lumosaily9/UWOC-FPGA/report/ai_collaboration.md

# 人机协作研发记录

项目名称：水下无线光通信智能收发终端

本记录按研发任务回溯整理，任务提示归纳工程问题，模型答复记录技术结论，人工反馈与验证结果共同构成问题闭环。协作贯穿系统架构、FPGA逻辑、软硬件接口、信号处理和测试验证。

## 一 协作组织与技术路线

团队负责应用需求、器件接口、硬件连接和工程取舍。大模型参与模块分解、时序分析、算法定点化、测试激励与异常定位。每项任务以明确的输入、输出和检查条件展开，通过源码分析及测试结果决定修改方向。

系统按PL实时处理、PS帧级调度、计算机数据接收划分。PL承担信道编解码、同步识别、串并转换和帧整理，PS承担FIFO水位读取、DMA控制、DDR缓存及UDP交付。幅度域扩展围绕选相、定点FFE和码元缓存单独组织。

## 二 系统架构与帧结构设计

**任务提示**

以Zynq-7010为处理平台，实现20 Mbps OOK水下光通信。请结合蓝光LD发射、单路PMT接收和以太网数据交付，划分PL与PS任务，明确帧结构及模块接口。

**模型答复与分析**

将固定节拍的串行收发、同步检测、RS编解码和字节交付放入PL，将整帧搬运与网络转发放入PS。发送端以239字节信息为输入，经RS(255,239)编码形成255字节码字，在码字前组织44 bit同步序列。接收端识别同步边界，恢复码字并译码，提取239字节信息后送入DMA。

**人工反馈与设计取舍**

团队确定20 Mbps OOK及现有光电接口，按发送、接收和质量观察三条通路组织功能。同步、帧末和有效握手作为模块之间的交接条件，PS以信息帧为单位调度数据。

**形成结果**

明确239字节信息、255字节码字和239字节网络载荷之间的关系，使编码、恢复和数据交付使用一致的帧边界。

## 三 串行时序分析与末位保持

**任务提示**

在200 MHz逻辑时钟下输出20 Mbps串行码流，检查位周期、字节边界、同步段与码字末位，分析最后一个字节恢复异常的原因。

**模型答复与分析**

200 MHz时钟周期为5 ns，每位保持10个时钟周期，对应50 ns位周期。由移位寄存器和位计数确定实际串行格式，数据字节按低位优先连续发送。码字末位输出后需要完整保持一个位周期，再退出发送状态。

**自我纠错轨迹**

最初从模块名称推断标准UART格式。追踪8位移位寄存器、位计数和同步状态后，将分析修正为连续8位字节与44 bit同步段。末字节设为0x80时，仿真暴露出最高位提前结束的问题，随后增加末位保持状态。非末字节切换仍按非阻塞赋值的旧值语义输出当前字节末位，同时装载下一字节。

**验证结果**

串行仿真恢复末字节0x80，末位完整保持10个周期。发送与接收自环核对255字节码字的首尾、顺序和帧末标志。

## 四 流接口反压与帧边界处理

**任务提示**

AXI流在连续就绪时能够传输，后级短时暂停后出现字节跳失。请检查数据消费条件、输出保持和TLAST位置，给出接收缓存的处理方式。

**模型答复与分析**

输入计数仅在TVALID与TREADY同时有效时推进。输出有效而后级未就绪时，保持TDATA、TLAST及有效标志。串行输入继续到达时，将已经恢复的等待字节与对应帧末标志共同保留，后级恢复后再交付。

**人工反馈与迭代**

将连续流激励扩展为间断就绪激励，分别检查码字组帧、信息提取和串行接收。根据失败字节位置核对计数推进，调整等待缓存的交付条件。

**验证结果**

反压场景下，两帧码字共510字节完整交付，信息提取输出两帧共478字节，数据与TLAST均与参考一致。接收缓存的配置同时结合串行字节间隔及后级停顿长度确定。

## 五 误码统计与计数位宽核对

**任务提示**

设计RS译码后载荷的误码统计，检查单字节全部错误、整帧全部错误及多帧累计，确定计数器位宽与串口输出格式。

**模型答复与分析**

接收载荷与参考序列逐位比较，每帧统计239字节，即1912 bit。单字节错误数范围为0至8，计数器需要4位。累计1000帧对应1 912 000 bit，串口输出四字节FF帧头和三字节错误计数。

**自我纠错轨迹**

单字节8位全错激励得到0，定位到3位中间计数器回绕。将位宽扩为4位后，分别注入0、1、8和1912个错误比特，核对中间计数及整帧累计结果。

**验证结果**

四组错误注入计数全部一致，误码统计使用RS译码后的有效载荷作为比较对象。

## 六 DMA调度与网络交付

**任务提示**

接收侧需要连续完成FIFO到DDR的数据搬运，并通过UDP交付信息帧。请检查DMA启动、完成、错误恢复和缓存一致性，分析忙状态无法释放及发送长度不一致的问题。

**模型答复与分析**

连续接收时，FIFO占用达到300字节后提交容量300字节的S2MM接收，当前信息帧在第239字节通过TLAST结束。DMA启动成功后置忙，完成中断使接收缓存失效并设置完成标志，主循环发送239字节UDP载荷后释放忙状态。错误中断设置错误标志，复位与调度恢复由主循环处理。

**人工反馈与迭代**

围绕启动失败、完成中断及异常恢复分别组织检查，避免一次失败阻断后续任务。网络发送函数按传入长度处理数据，信息帧调用保持239字节。

**验证结果**

UDP、DMA和主循环三组主机C函数测试通过。本地UDP回环接收3个数据报，共717字节，保存内容逐字节一致。

## 七 幅度域FFE与缓存优化

**任务提示**

为20 MBd OOK构建幅度域处理扩展，采样率120 MSa/s。请设计码元选相、五抽头FFE及定点数据格式，并分析业务缓存保存全部样点与仅保存码元幅度的资源差异。

**模型答复与分析**

每码元包含6个样点，选相后将12位码元幅度写入保护FIFO，读出后减去2048转为有符号样值，再进入码元间隔五抽头FFE。系数为16位有符号Q13数，乘积采用28位，累加采用31位，右移13位后饱和为12位输出，再进行门限判决。

**人工反馈与设计取舍**

按有效信号管理样值推进，后级暂停时保持流水数据。将码元选样放在业务FIFO之前，使缓存深度按码元数配置，保留定点乘加、饱和和帧内参数稳定的接口约束。

**验证结果**

扩展RTL完成6组回归。4组系数下4096个样值与整数参考一致，覆盖正负饱和和反压保持。相同1024码元配置下，FIFO逻辑数据容量由73 728 bit降为12 288 bit，减少83.33%。

## 八 协作工作流与问题闭环

研发任务按PL逻辑、PS控制、测试验证和系统集成分解。模型分析源码与约束，提出实现或激励方案，团队确定接口和取舍，再以测试结果反馈修订。

工作流为：需求与接口输入 → 模块拆解 → 模型分析 → 人工取舍 → 实现与测试 → 失败定位 → 修订回归 → 系统集成。
