lumosaily9/UWOC-FPGA/sim/results/baseline/README.md

# 优化前对比回归

本目录保存原始RTL在20 Mbps、200 MHz测试配置下的运行日志。相同激励由当前sim目录的测试提供，10项用例中3项通过。优化后的结果位于上一级目录，10项全部通过。

原始工程提交为13d41ebe76c9aa6b042e6da6cba2ef24ab2048f2。该目录用于对应设计报告第4章的优化前后对比。
