lumosaily9/UWOC-FPGA/src/ip_repo/uart2fifo_v2/uart2fifo_50m.v

module uart2fifo_v2 #(
   parameter CLK_FREQ = 200_000_000,   // 系统时钟频率 (200 MHz)
    parameter BAUD_RATE = 20_000_000    // 串行码元速率 (20 MBd)
)(
    // Global Signals
    input               clk,        // 系统时钟
    input               resetn,
    
    // RS Signals 
    input               data_in,    // 串行数据输入
    
    // AXI-Stream Master Interface
    output reg          m_axis_tvalid,
    output reg  [7:0]   m_axis_tdata,
    output reg          m_axis_tlast,  // 数据包结束标志
    input               m_axis_tready,
     output wire  [0:0]      Waiting_first_high,
      output wire  [0:0]      First_high_valid,
      output wire   [0:0]      Half_sample_done, 
    output wire   [2:0]    state
    
); 

// 接收状态机
reg     [15:0]  clk_cnt;        // 波特率计数器
reg     [7:0]   data_buf;       // 数据缓存
reg     [3:0]   data_cnt;       // 数据位计数器
reg     [2:0]   STATE;          // 主状态机
reg     [7:0]   pkt_counter;    // 数据包字节计数器 (0-254)

// 接收等待缓存寄存器
reg     [7:0]   pending_data;   // 等待发送的数据缓存
reg             has_pending;    // 缓存有效标志

reg pending_last;

// ============= 同步序列检测寄存器 =============
reg     [31:0]  sync_shift_reg; // 同步序列移位寄存器
reg     [7:0]   sync_cnt;       // 同步序列位计数器
reg             sync_detected;  // 同步序列检测标志
reg     [7:0]   zero_cnt;       // 连续0计数器
reg      [0:0]       waiting_first_high; // 等待第一个高电平标志
reg       [0:0]      first_high_valid;
reg       [0:0]     half_sample_done;   // 半周期采样完成标志
reg [0:0] flag;
reg [2:0] safe;
// =================================================

// 动态计算波特率分频系数
localparam BAUD_DIV = (CLK_FREQ / BAUD_RATE) - 1;  // 波特率分频系数
localparam HALF_BAUD_DIV = (BAUD_DIV + 1) / 2 - 1; // 半波特率周期值

// 接收状态定义
localparam [2:0] 
    SYNC_DETECT = 3'b000,   // 同步序列检测状态
    IDLE        = 3'b001,
    START       = 3'b010,
    STOP        = 3'b011;

// 同步序列常量 (00010101010101010101 低位先发)
localparam [31:0] SYNC_PATTERN = 32'b01010101010101010101010101010101;
assign state=STATE;
assign  Waiting_first_high= waiting_first_high;
assign  First_high_valid= first_high_valid;
assign  Half_sample_done = half_sample_done; 


wire byte_complete = (STATE == START) && (clk_cnt == BAUD_DIV) && (data_cnt == 8);

// 主状态机
always @(posedge clk or negedge resetn) begin
    if (!resetn) begin
        STATE           <= SYNC_DETECT;  // 复位后进入同步检测状态
        clk_cnt         <= 16'h0;
        data_cnt        <= 4'h0;
        data_buf        <= 8'h00;
        m_axis_tvalid   <= 1'b0;
        m_axis_tdata    <= 8'h0;
        m_axis_tlast    <= 1'b0;
        pkt_counter     <= 8'd0;
        pending_data    <= 8'h0;
        has_pending     <= 1'b0;
        pending_last    <= 1'b0;

        
        // ============= 同步检测复位 =============
        sync_shift_reg  <= 32'h0;
        sync_cnt        <= 6'h0;
        sync_detected   <= 1'b0;
        zero_cnt        <= 8'h0;
        waiting_first_high <= 1'b0;
        half_sample_done   <= 1'b0;
        first_high_valid    <= 1'b0;
          flag<=1'b0;
        // =========================================
    end 
    else begin
        // Two-entry elastic output: data/last remain stable until accepted.
        if (m_axis_tvalid && m_axis_tready) begin
            if (has_pending) begin
                m_axis_tdata <= pending_data;
                m_axis_tlast <= pending_last;
                m_axis_tvalid <= 1'b1;
                has_pending <= 1'b0;
            end else begin
                m_axis_tvalid <= 1'b0;
                m_axis_tlast <= 1'b0;
            end
        end
        if (byte_complete) begin
            if (!m_axis_tvalid || (m_axis_tready && !has_pending)) begin
                m_axis_tdata <= data_buf;
                m_axis_tlast <= (pkt_counter == 8'd254);
                m_axis_tvalid <= 1'b1;
            end else if (!has_pending || m_axis_tready) begin
                pending_data <= data_buf;
                pending_last <= (pkt_counter == 8'd254);
                has_pending <= 1'b1;
            end
        end
        case (STATE)
            // ============= 同步序列检测 =============
             SYNC_DETECT: begin

          
                
                // 波特率计数
                if (!waiting_first_high) begin
                 if (clk_cnt == BAUD_DIV)begin
                    clk_cnt <= 0;
                    
                    // 阶段1: 检测连续8位0
                    if (!waiting_first_high && !half_sample_done) begin
                        if (data_in == 1'b0) begin
                            if (zero_cnt == 8'd6) begin
                                // 检测到连续8位0，进入等待高电平阶段
                                waiting_first_high <= 1'b1;
                                zero_cnt <= 8'h0;
                                 STATE <= SYNC_DETECT;
                            end else begin
                                zero_cnt <= zero_cnt + 1;
                                 STATE <= SYNC_DETECT;
                            end
                        end else begin
                            zero_cnt <= 8'h0; // 遇到1，清零计数器
                            STATE <= SYNC_DETECT;
                        end
                    end 
                    end else begin
                    clk_cnt <= clk_cnt + 1;
                    STATE <= SYNC_DETECT;
                    end
                end
                    // 阶段2: 等待第一个高电平并验证
                   if (waiting_first_high && !half_sample_done) begin
                        if (data_in == 1'b1) begin
                            // 检测到高电平，启动半周期验证
                            zero_cnt <= 8'h0;
                            half_sample_done <= 1'b1;
                            clk_cnt <= 0; // 重置计数器用于半周期采样
                            STATE <= SYNC_DETECT;
                        end 
                    end
                    // 阶段3: 半周期后验证高电平
                    if (half_sample_done && !first_high_valid) begin
                     if (clk_cnt == HALF_BAUD_DIV)begin
                        if (data_in == 1'b1) begin
                            // 高电平验证成功，开始检测32位交替同步模式
                         
                             first_high_valid<= 1'b1;
                             sync_shift_reg <= {data_in, sync_shift_reg[31:1]};
                            sync_cnt <= sync_cnt + 1;  
                            clk_cnt <= 0;
                            STATE <= SYNC_DETECT;
                        end else begin
                            // 验证失败，重新开始
                            half_sample_done <= 1'b0;
                            zero_cnt <= 8'h0;
                            waiting_first_high <= 1'b0;
                            STATE <= SYNC_DETECT;
                        end
                        end else begin
                        clk_cnt <= clk_cnt + 1;
                        STATE <= SYNC_DETECT;
                        end
                    end
                    // 阶段4: 检测32位交替同步模式
                    if ( first_high_valid) begin
                        if (clk_cnt == BAUD_DIV) begin
                            clk_cnt <= 0;
                            sync_shift_reg <= {data_in, sync_shift_reg[31:1]};
                            sync_cnt <= sync_cnt + 1;
                         
                            // 完成交替模式采样后进行比较
                            if (sync_cnt == 8'd32) begin
                                if (sync_shift_reg == SYNC_PATTERN) begin
                                    first_high_valid   <=1'b0;
                                    sync_shift_reg  <=32'd0;
                                     zero_cnt <= 8'h0;
                                      half_sample_done    <=1'b0;
                                    sync_cnt <= 6'h0;
                                     waiting_first_high <= 1'b0;
                                    STATE <= IDLE;
                                end else begin
                                    // 同步序列不匹配，重新开始检测
                                    first_high_valid   <=1'b0;
                                    zero_cnt <= 8'h0;
                                    sync_cnt <= 6'h0;
                                      half_sample_done    <=1'b0;
                                    sync_shift_reg<=32'd0;
                                    waiting_first_high <= 1'b0;
                                    STATE <= SYNC_DETECT;
                                end
                            end
                        end else begin
                            clk_cnt <= clk_cnt + 1;
                            STATE <= SYNC_DETECT;
                        end
                    end
                end 
            
            // =============================================
            
            // IDLE状态：优先处理缓存数据
            IDLE: begin

                sync_shift_reg  <= 32'h0;
                data_buf <= 8'h00;
                // 优先发送缓存数据
            
                // 检测起始位 (现在是1)
               
         if(flag==1)begin
                
            if (clk_cnt == HALF_BAUD_DIV-1) begin 
                // 半周期后再次确认电平状态
                if (data_in == 1'b1) begin
                    flag<=0;
                    clk_cnt  <= 0;
                    data_cnt <= 1;
                    data_buf <= {data_in, data_buf[7:1]};
                    STATE    <= START;
                end else begin
                    // 半周期后电平变为低，说明是毛刺，重新开始检测
                    clk_cnt <= 0;
                    flag<=0;
                      STATE    <= IDLE;
                end
            end 
            else begin
                clk_cnt <= clk_cnt + 1;
                  STATE    <= IDLE;
            end
        end
        else if (flag==0)begin
          STATE    <= IDLE;
        if(data_in==1)begin
        flag<=1;
        end
        end
            end       

            
            // 接收8位数据
            START: begin
                if (clk_cnt == BAUD_DIV) begin
                    clk_cnt  <= 0;
                    data_buf <= {data_in, data_buf[7:1]}; 
                    
                    if (data_cnt == 8) begin 
                    data_cnt <=1;
                      if (pkt_counter == 8'd254) begin
                            pkt_counter <= 8'd0;   // 包结束，计数器清零
                             STATE <= SYNC_DETECT;
                        end else begin
                            pkt_counter <= pkt_counter + 1; // 包内下一个字节
                            STATE <= START;
                        end
                        // Completed bytes enter the output queue below.
                        // 状态转换
                    end 
                    else begin
                        data_cnt <= data_cnt + 1;
                         STATE <= START;
                    end
                end 
                else begin
                    clk_cnt <= clk_cnt + 1;
                    STATE <= START;
                end
            end
            
            // 停止位处理
    
            default: STATE <= SYNC_DETECT;

        endcase
    end
end

endmodule  
