lumosaily9/UWOC-FPGA/src/ps/rx/udp_perf_server.c

#include <stdio.h>
#include <string.h>
#include "lwip/err.h"
#include "lwip/udp.h"
#include "xil_printf.h"
#include "lwip/inet.h"

static struct udp_pcb *pcb;

#define SER_PORT 5001

//打印应用程序
void print_app_header()
{
    xil_printf("\r\n-----Network port UDP transmission camera video display on upper computer ------\r\n");
}

//UDP发送功能函数
void udp_tx_data(u8 *buffer_ptr,unsigned int len){
    static struct pbuf *ptr;

    if (pcb == NULL || buffer_ptr == NULL || len == 0U || len > 65507U) {
        return;
    }
    ptr = pbuf_alloc(PBUF_TRANSPORT, (u16_t)len, PBUF_POOL); /* 申请内存 */

    if (ptr)
    {
        pbuf_take(ptr, buffer_ptr, (u16_t)len); /* 将buffer_ptr中的数据打包进pbuf结构中 */
        udp_send(pcb, ptr);              /* udp发送数据 */
        pbuf_free(ptr);                  /* 释放内存 */
    }
}

void start_application()
{
    err_t err;

    /* 设置客户端的IP地址 */

    ip_addr_t DestIPaddr;

    IP4_ADDR( &DestIPaddr,192,168,253,104);

    //创建新的UDP PCB
    pcb = udp_new();
    if (!pcb) {
        xil_printf("Error creating PCB. Out of Memory\r\n");
        return;
    }

    //绑定端口
    err = udp_bind(pcb, IP_ADDR_ANY, SER_PORT);
    if (err != ERR_OK) {
        xil_printf("Unable to bind to port %d; err %d\r\n",
                SER_PORT, err);
        udp_remove(pcb);
        pcb = NULL;
        return;
    }
    /* 设置客户端的端口 */
    err = udp_connect(pcb, &DestIPaddr, SER_PORT);
    if (err != ERR_OK) {
        xil_printf("UDP connect failed: %d\r\n", err);
        udp_remove(pcb);
        pcb = NULL;
        return;
    }

    xil_printf("UDP server started @ port %d\n\r", SER_PORT);
}
